RBSC/SideSlotCartridgeAdapter/Pics/cart_in.jpg

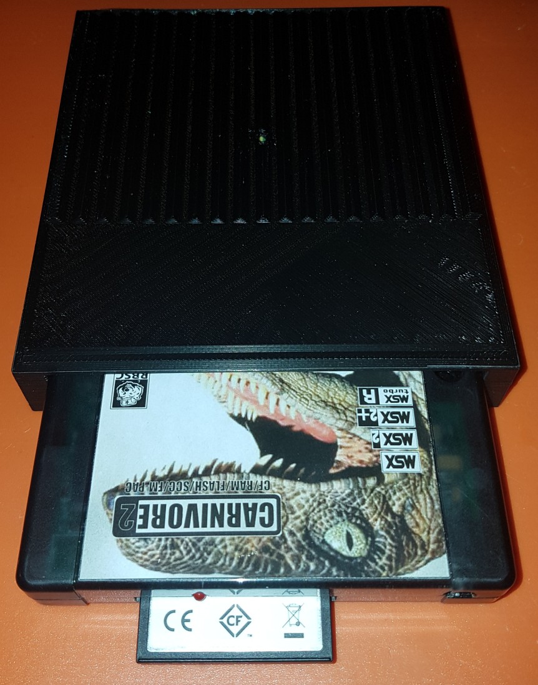
Pics/cart_in.jpg
