RBSC/SideSlotCartridgeAdapter/Pics/inserted.jpg

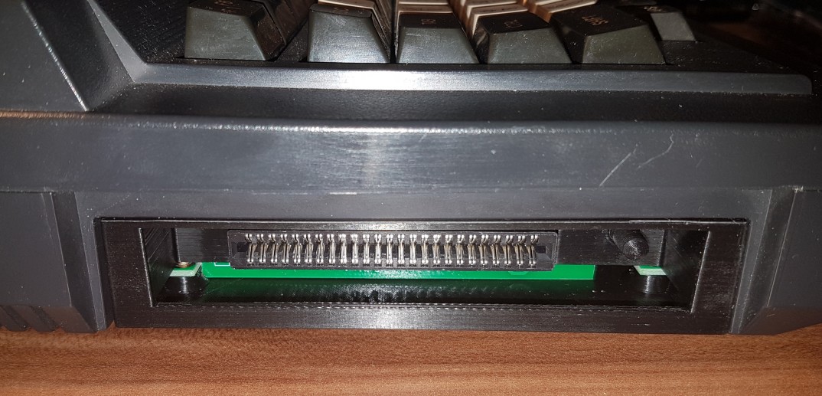
Pics/inserted.jpg
