RBSC/SideSlotCartridgeAdapter/Pics/cart_in_msx.jpg

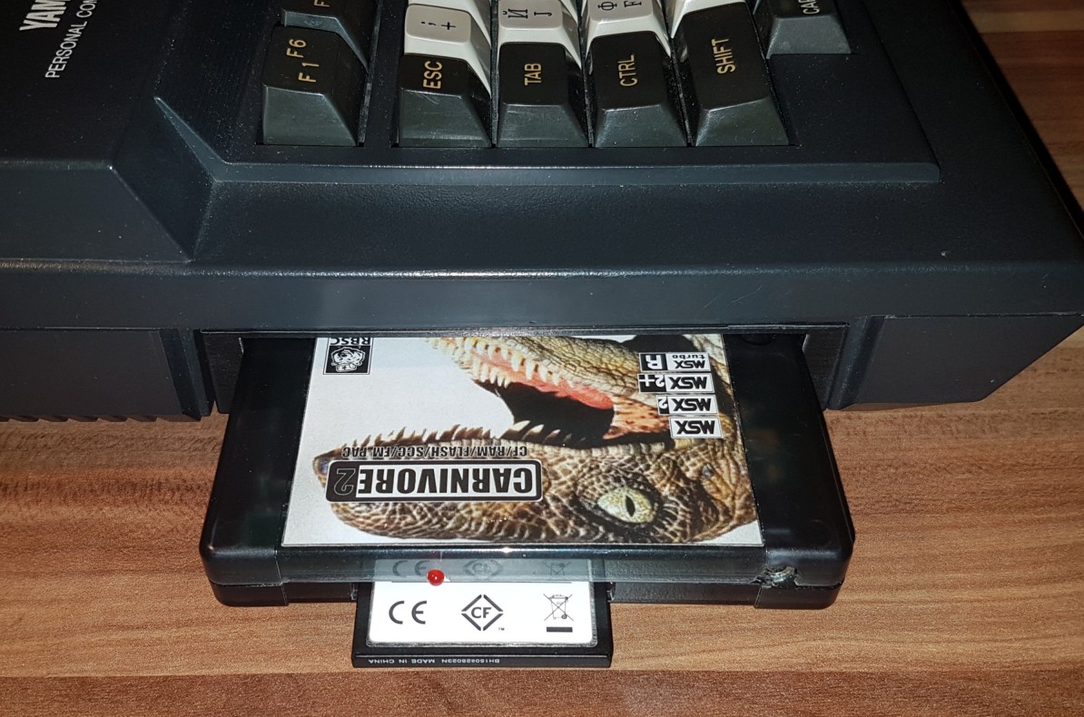
Pics/cart_in_msx.jpg
