RBSC/SideSlotCartridgeAdapter/Pics/internals.jpg

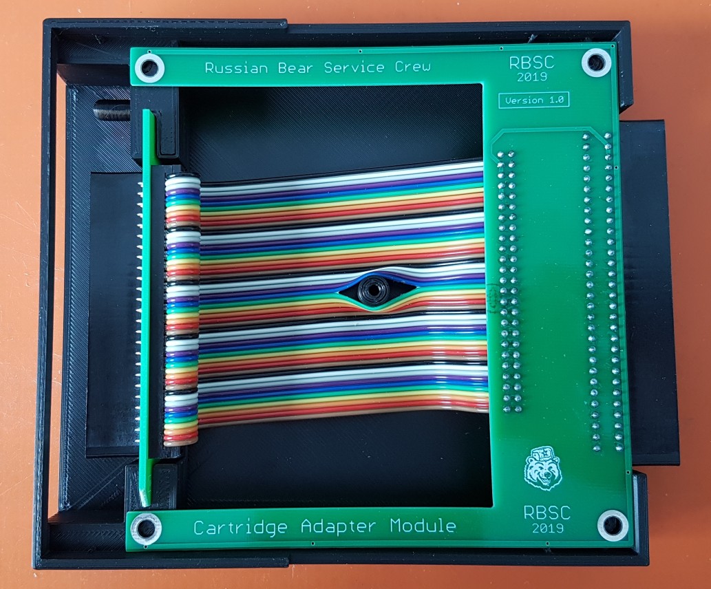
Pics/internals.jpg
