RBSC/SideSlotCartridgeAdapter/Pics/model.jpg

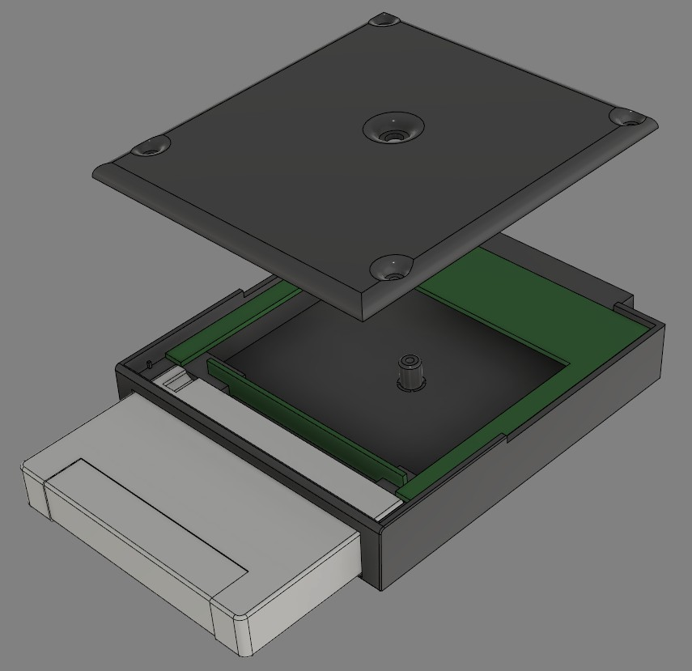
Pics/model.jpg
