RBSC/SideSlotCartridgeAdapter/Pics/sideview.jpg

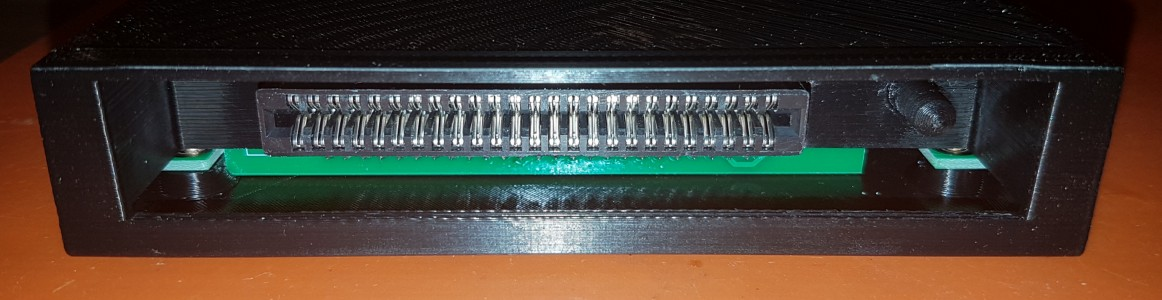
Pics/sideview.jpg
