RBSC/SideSlotCartridgeAdapter/Pics/slotcover.jpg

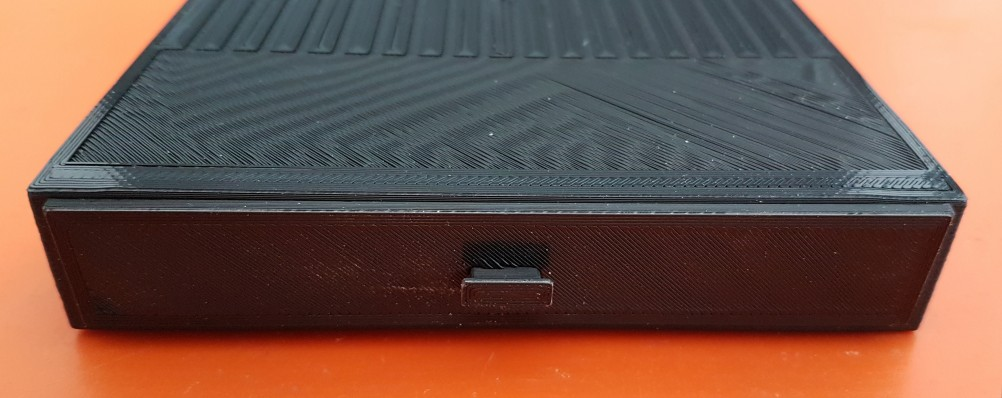
Pics/slotcover.jpg
