RBSC/SideSlotCartridgeAdapter/Case/SlotCoverHandle.stl

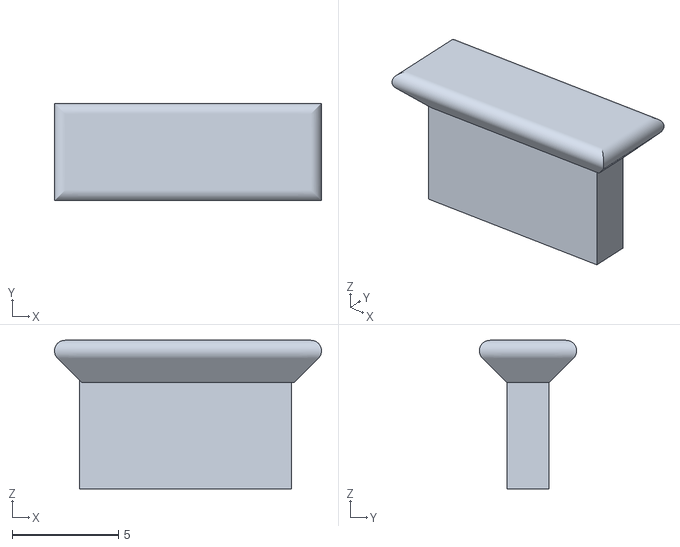
[picture p8: CAD file, 2019-05-01]
Case/SlotCoverHandle.stl
12.6 x 4.59 x 7.00
