RBSC/SideSlotCartridgeAdapter/Case/SlotCover.stl

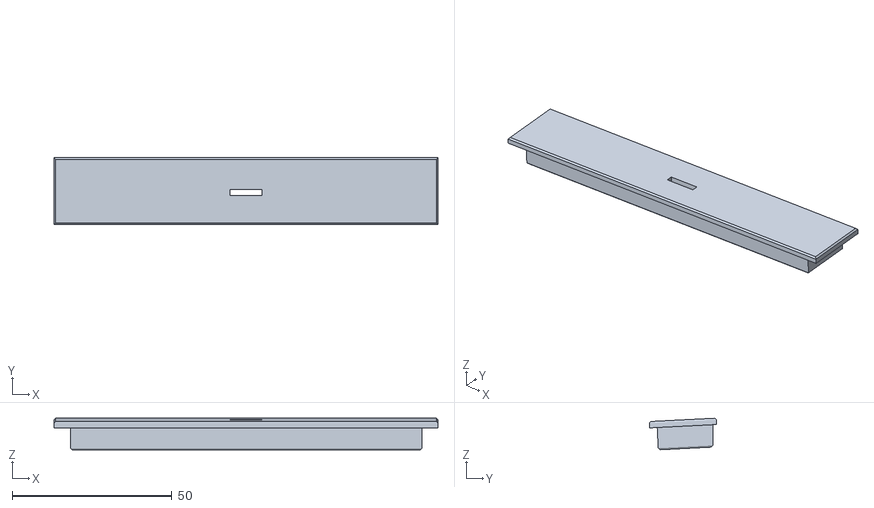
[picture p9: CAD file, 2019-05-01]
Case/SlotCover.stl
120.2 x 21.0 x 9.88
