RBSC/SideSlotCartridgeAdapter/Case/SlotCover_Noholes.stl

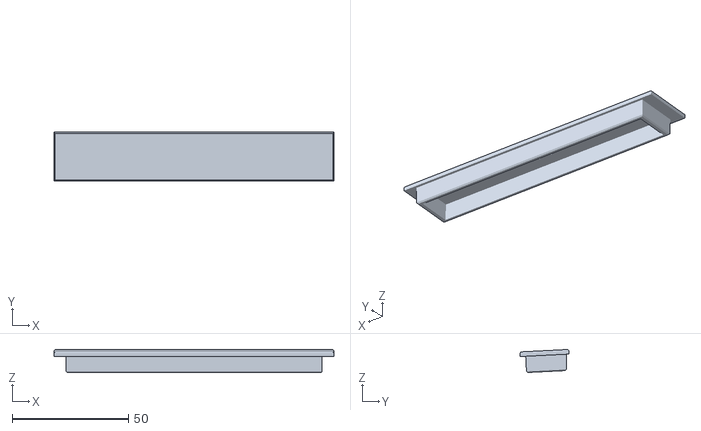
[picture p10: CAD file, 2019-05-01]
Case/SlotCover_Noholes.stl
120.2 x 21.0 x 9.88
