RBSC/SideSlotCartridgeAdapter/Case/Pin.stl

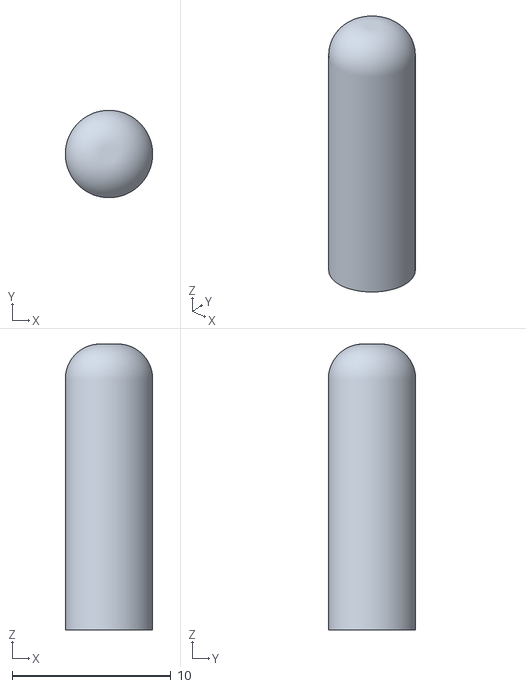
[picture p11: CAD file, 2019-04-03]
Case/Pin.stl
5.50 x 5.50 x 18.0
