RBSC/SideSlotCartridgeAdapter/Case/Case.stl

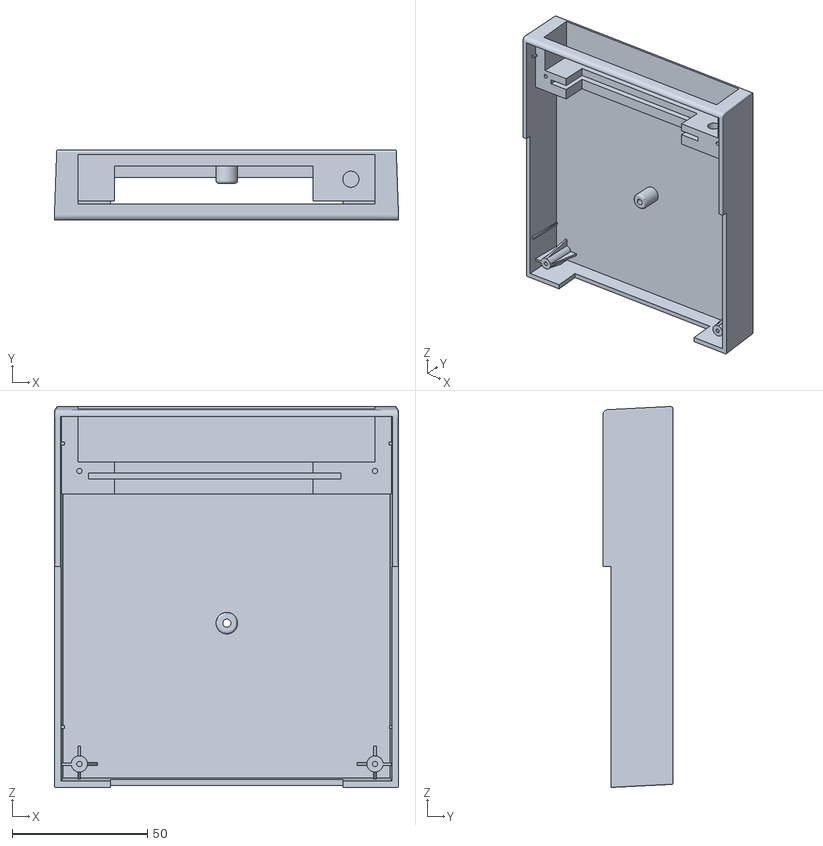
[picture p12: CAD file, 2019-04-03]
Case/Case.stl
127.6 x 26.0 x 141.1
