RBSC/SideSlotCartridgeAdapter/Case/Cover.stl

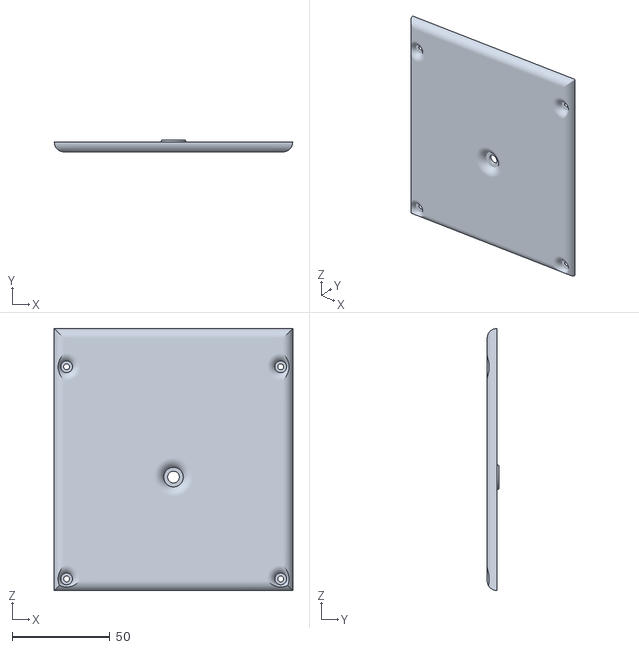
[picture p13: CAD file, 2019-04-03]
Case/Cover.stl
122.0 x 6.00 x 134.0
