RBSC/SideSlotCartridgeAdapter/Boards/cartridge_adapter.sch

## EAGLE design Boards/cartridge_adapter.sch (2019-04-03)

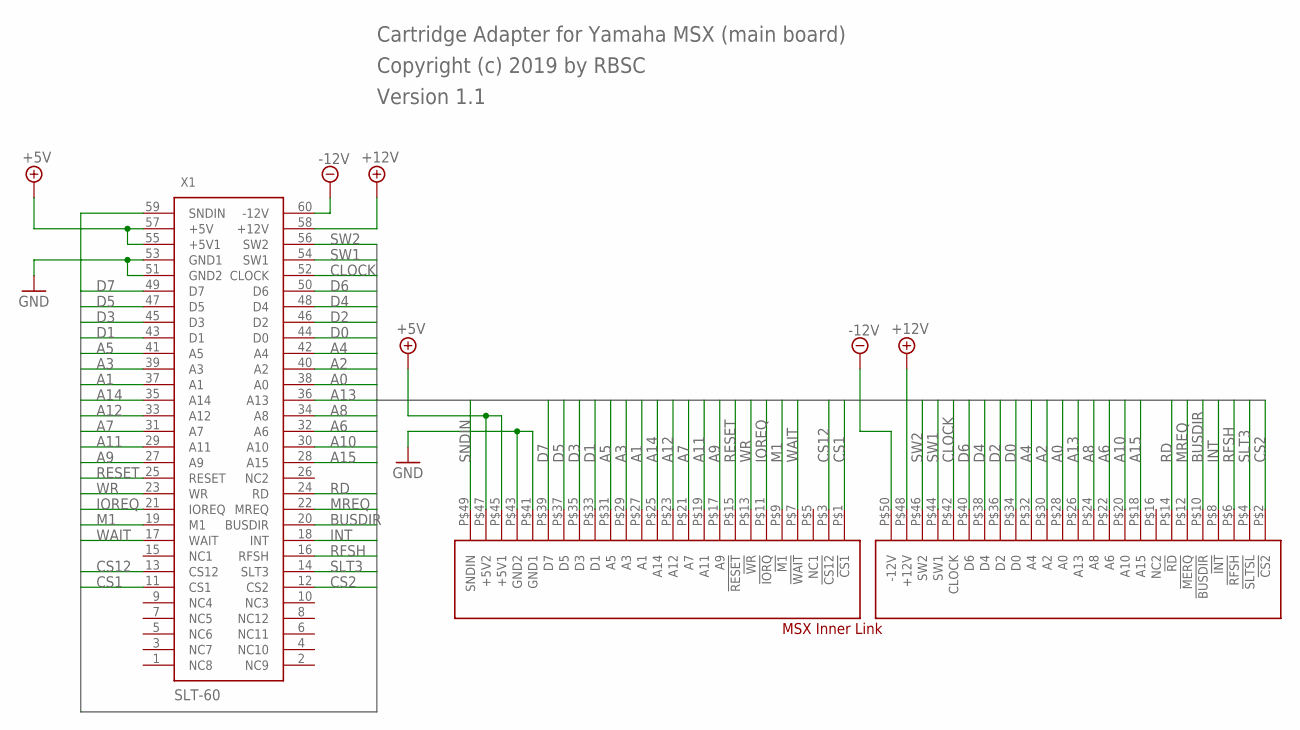
[picture p14: schematic cartridge_adapter.sch]

Parts:
CN3: MSX_INNER_LINK
X1: SLT-60

Connections:
+5V: CN3.P$45 (+5V1), CN3.P$47 (+5V2), X1.55 (+5V1), X1.57 (+5V)
+12V: CN3.P$48 (+12V), X1.58 (+12V)
-12V: CN3.P$50 (-12V), X1.60 (-12V)
A0: CN3.P$28 (A0), X1.38 (A0)
A1: CN3.P$27 (A1), X1.37 (A1)
A2: CN3.P$30 (A2), X1.40 (A2)
A3: CN3.P$29 (A3), X1.39 (A3)
A4: CN3.P$32 (A4), X1.42 (A4)
A5: CN3.P$31 (A5), X1.41 (A5)
A6: CN3.P$22 (A6), X1.32 (A6)
A7: CN3.P$21 (A7), X1.31 (A7)
A8: CN3.P$24 (A8), X1.34 (A8)
A9: CN3.P$17 (A9), X1.27 (A9)
A10: CN3.P$20 (A10), X1.30 (A10)
A11: CN3.P$19 (A11), X1.29 (A11)
A12: CN3.P$23 (A12), X1.33 (A12)
A13: CN3.P$26 (A13), X1.36 (A13)
A14: CN3.P$25 (A14), X1.35 (A14)
A15: CN3.P$18 (A15), X1.28 (A15)
BUSDIR: CN3.P$10 (!BUSDIR), X1.20 (BUSDIR)
CLOCK: CN3.P$42 (CLOCK), X1.52 (CLOCK)
CS1: CN3.P$1 (!CS1), X1.11 (CS1)
CS2: CN3.P$2 (!CS2), X1.12 (CS2)
CS12: CN3.P$3 (!CS12), X1.13 (CS12)
D0: CN3.P$34 (D0), X1.44 (D0)
D1: CN3.P$33 (D1), X1.43 (D1)
D2: CN3.P$36 (D2), X1.46 (D2)
D3: CN3.P$35 (D3), X1.45 (D3)
D4: CN3.P$38 (D4), X1.48 (D4)
D5: CN3.P$37 (D5), X1.47 (D5)
D6: CN3.P$40 (D6), X1.50 (D6)
D7: CN3.P$39 (D7), X1.49 (D7)
GND: CN3.P$41 (GND1), CN3.P$43 (GND2), X1.51 (GND2), X1.53 (GND1)
INT: CN3.P$8 (!INT), X1.18 (INT)
IOREQ: CN3.P$11 (!IORQ), X1.21 (IOREQ)
M1: CN3.P$9 (!M1), X1.19 (M1)
MREQ: CN3.P$12 (!MERQ), X1.22 (MREQ)
RD: CN3.P$14 (!RD), X1.24 (RD)
RESET: CN3.P$15 (!RESET), X1.25 (RESET)
RFSH: CN3.P$6 (!RFSH), X1.16 (RFSH)
SLT3: CN3.P$4 (!SLTSL), X1.14 (SLT3)
SNDIN: CN3.P$49 (SNDIN), X1.59 (SNDIN)
SW1: CN3.P$44 (SW1), X1.54 (SW1)
SW2: CN3.P$46 (SW2), X1.56 (SW2)
WAIT: CN3.P$7 (!WAIT), X1.17 (WAIT)
WR: CN3.P$13 (!WR), X1.23 (WR)

Notes on the sheet:
Cartridge Adapter for Yamaha MSX (main board)
Copyright (c) 2019 by RBSC
Version 1.1
