RBSC/SideSlotCartridgeAdapter/Boards/cartridge_adapter_ext.sch

## EAGLE design Boards/cartridge_adapter_ext.sch (2019-04-03)

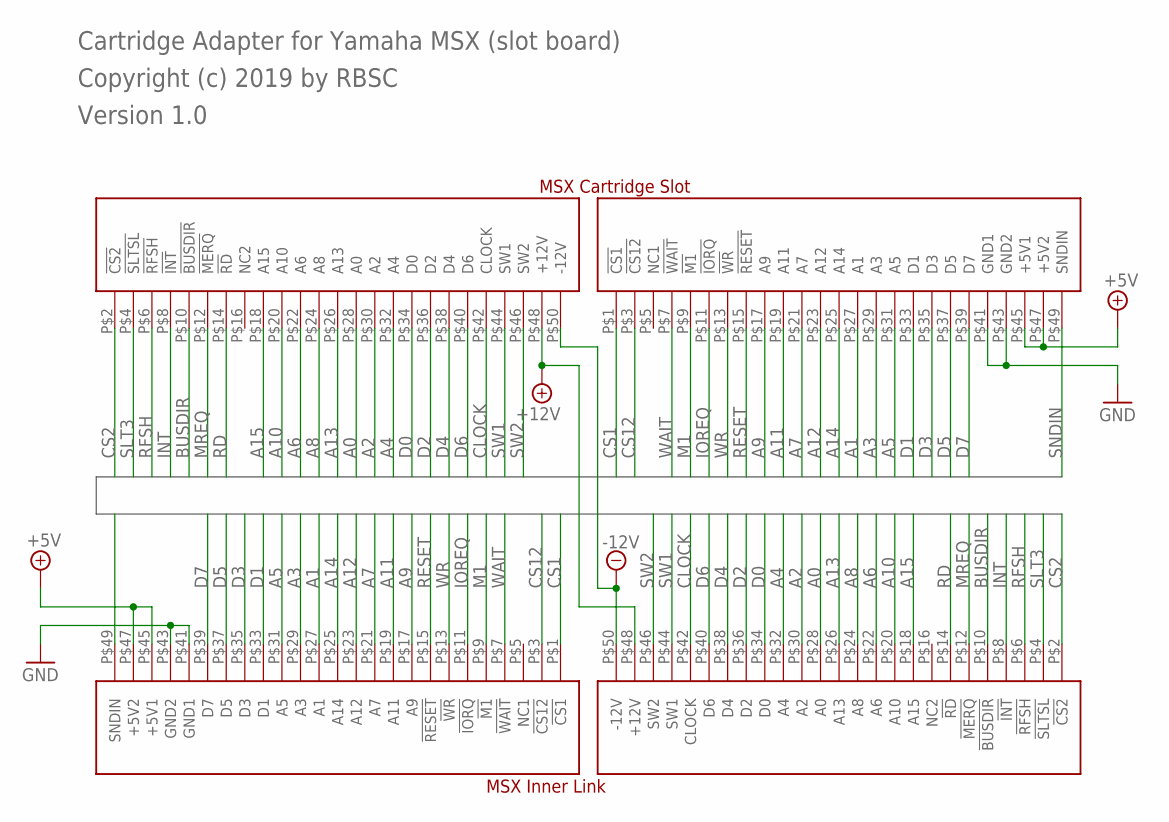
[picture p15: schematic cartridge_adapter_ext.sch]

Parts:
CN1: MSX_SLOT
CN2: MSX_INNER_LINK

Connections:
+5V: CN1.P$45 (+5V1), CN1.P$47 (+5V2), CN2.P$45 (+5V1), CN2.P$47 (+5V2)
+12V: CN1.P$48 (+12V), CN2.P$48 (+12V)
-12V: CN1.P$50 (-12V), CN2.P$50 (-12V)
A0: CN1.P$28 (A0), CN2.P$28 (A0)
A1: CN1.P$27 (A1), CN2.P$27 (A1)
A2: CN1.P$30 (A2), CN2.P$30 (A2)
A3: CN1.P$29 (A3), CN2.P$29 (A3)
A4: CN1.P$32 (A4), CN2.P$32 (A4)
A5: CN1.P$31 (A5), CN2.P$31 (A5)
A6: CN1.P$22 (A6), CN2.P$22 (A6)
A7: CN1.P$21 (A7), CN2.P$21 (A7)
A8: CN1.P$24 (A8), CN2.P$24 (A8)
A9: CN1.P$17 (A9), CN2.P$17 (A9)
A10: CN1.P$20 (A10), CN2.P$20 (A10)
A11: CN1.P$19 (A11), CN2.P$19 (A11)
A12: CN1.P$23 (A12), CN2.P$23 (A12)
A13: CN1.P$26 (A13), CN2.P$26 (A13)
A14: CN1.P$25 (A14), CN2.P$25 (A14)
A15: CN1.P$18 (A15), CN2.P$18 (A15)
BUSDIR: CN1.P$10 (!BUSDIR), CN2.P$10 (!BUSDIR)
CLOCK: CN1.P$42 (CLOCK), CN2.P$42 (CLOCK)
CS1: CN1.P$1 (!CS1), CN2.P$1 (!CS1)
CS2: CN1.P$2 (!CS2), CN2.P$2 (!CS2)
CS12: CN1.P$3 (!CS12), CN2.P$3 (!CS12)
D0: CN1.P$34 (D0), CN2.P$34 (D0)
D1: CN1.P$33 (D1), CN2.P$33 (D1)
D2: CN1.P$36 (D2), CN2.P$36 (D2)
D3: CN1.P$35 (D3), CN2.P$35 (D3)
D4: CN1.P$38 (D4), CN2.P$38 (D4)
D5: CN1.P$37 (D5), CN2.P$37 (D5)
D6: CN1.P$40 (D6), CN2.P$40 (D6)
D7: CN1.P$39 (D7), CN2.P$39 (D7)
GND: CN1.P$41 (GND1), CN1.P$43 (GND2), CN2.P$41 (GND1), CN2.P$43 (GND2)
INT: CN1.P$8 (!INT), CN2.P$8 (!INT)
IOREQ: CN1.P$11 (!IORQ), CN2.P$11 (!IORQ)
M1: CN1.P$9 (!M1), CN2.P$9 (!M1)
MREQ: CN1.P$12 (!MERQ), CN2.P$12 (!MERQ)
RD: CN1.P$14 (!RD), CN2.P$14 (!RD)
RESET: CN1.P$15 (!RESET), CN2.P$15 (!RESET)
RFSH: CN1.P$6 (!RFSH), CN2.P$6 (!RFSH)
SLT3: CN1.P$4 (!SLTSL), CN2.P$4 (!SLTSL)
SNDIN: CN1.P$49 (SNDIN), CN2.P$49 (SNDIN)
SW1: CN1.P$44 (SW1), CN2.P$44 (SW1)
SW2: CN1.P$46 (SW2), CN2.P$46 (SW2)
WAIT: CN1.P$7 (!WAIT), CN2.P$7 (!WAIT)
WR: CN1.P$13 (!WR), CN2.P$13 (!WR)

Notes on the sheet:
Cartridge Adapter for Yamaha MSX (slot board)
Copyright (c) 2019 by RBSC
Version 1.0
