RBSC/SideSlotCartridgeAdapter/(commit log)

2019-04-03 Release 03.04.2019
    First release. Includes all necessary files to produce the device.
    [Case.stl, Cover.stl, Pin.stl, cartridge_adapter.brd, cartridge_adapter.sch, cartridge_adapter_ext.brd, cartridge_adapter_ext.sch]
2019-05-01 Update 01.05.2019
    Added models of the side slot cover and its handle
    [SlotCover.stl, SlotCoverHandle.stl, SlotCover_Noholes.stl]
